ACEVS4US/BMS_SLAVE_REV2/bms_slave.brd

## EAGLE design bms_slave.brd (2021-01-10)

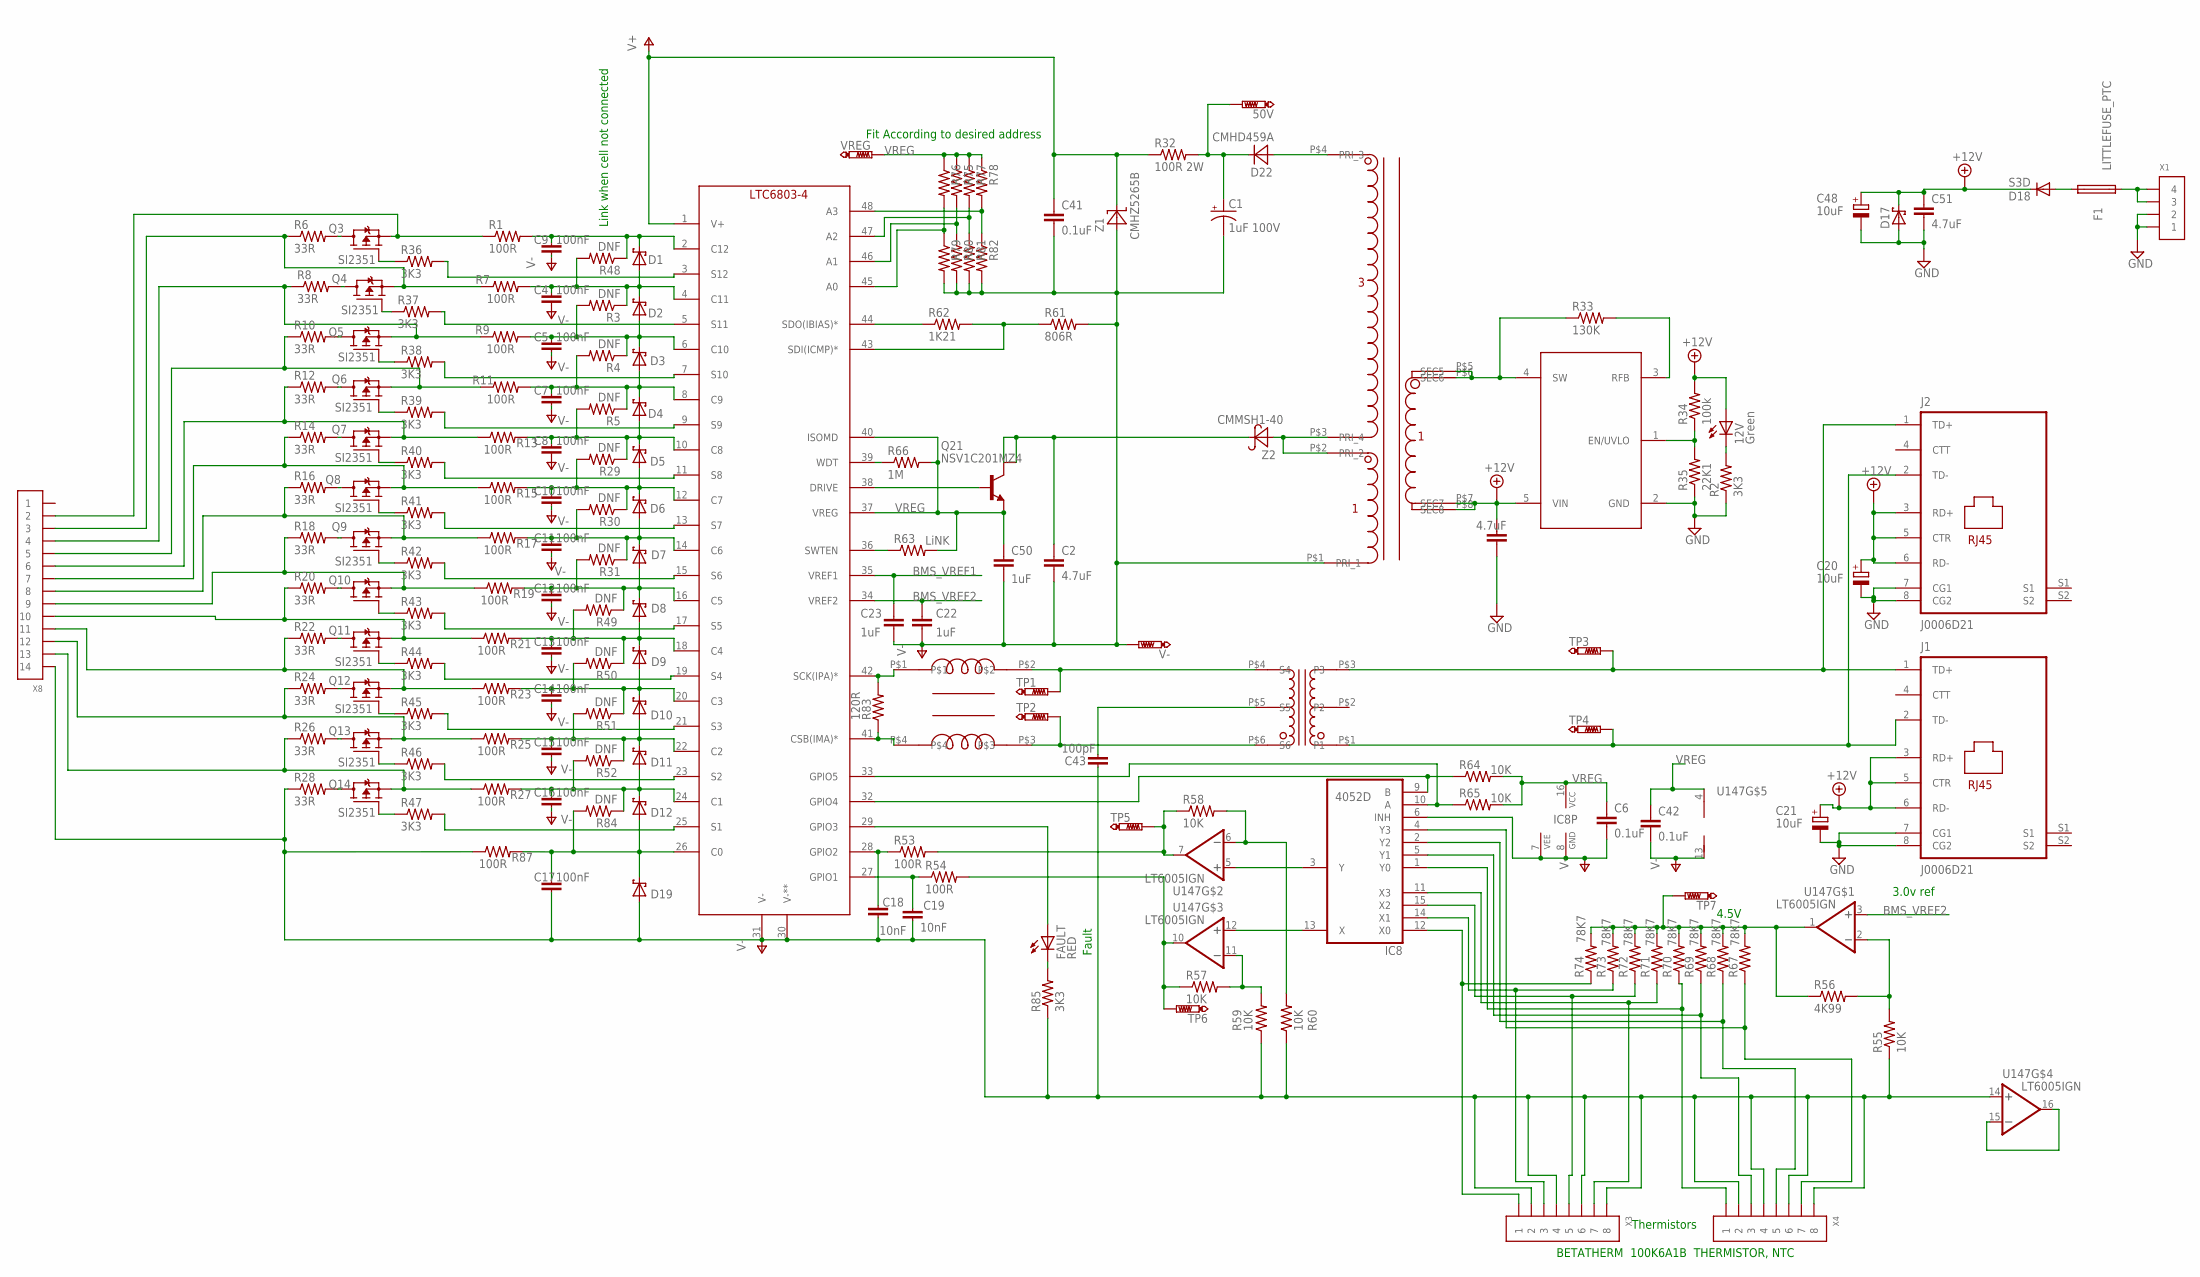
[picture p1: schematic bms_slave.sch]

Parts:
12V: Green; CHIP-LED0805
50V: PTR1PAD1-13; P1-13
C1: 1uF 100V; SMC_D
C2, C3, C51: 4.7uF; C1206
C4, C5, C7, C8, C9, C10, C11, C12, C13, C14, C15, C16, C17: 100nF; C0603@1
C6, C41, C42: 0.1uF; C1206
C18, C19: 10nF; C0603@1
C20, C21, C48: 10uF; SMC_D
C22, C23, C50: 1uF; C1206
C43: 100pF; C1206@1
D1, D2, D3, D4, D5, D6, D7, D8, D9, D10, D11, D12, D19: SMF5.0AT1; SOD123FL
D17: SCHOTTKY-DIODESMC; SMC
D18: S3D; SMC
D22: CMHD459A; SOD123
F1: LITTLEFUSE_PTC; 1812
FAULT: RED; CHIP-LED0805
IC8: 4052D; SO16
J1, J2: J0006D21; J0-C/D/E
Q3, Q4, Q5, Q6, Q7, Q8, Q9, Q10, Q11, Q12, Q13, Q14: SI2351; SOT23
Q21: NSV1C201MZ4; SOT223
R1, R7, R9, R11, R13, R15, R17, R19, R21, R23, R25, R27, R53, R54, R87: 100R; R0603
R2, R36, R37, R38, R39, R40, R41, R42, R43, R44, R45, R46, R47, R85: 3K3; R0603
R3, R4, R5, R29, R30, R31, R48, R49, R50, R51, R52, R84: DNF; R0603
R6, R8, R10, R12, R14, R16, R18, R20, R22, R24, R26, R28: 33R; R2512
R32: 100R 2W; R2512
R33: 130K; R0603
R34: 100k; R0603
R35: 22K1; R0603
R55, R57, R58, R59, R60, R64, R65: 10K; R0603
R56: 4K99; R0603
R61: 806R; R0603
R62: 1K21; R0603
R63: LiNK; R0603
R66: 1M; R0603
R67, R68, R69, R70, R71, R72, R73, R74: 78K7; R0603
R75, R76, R77, R78, R79, R80, R81, R82: R-US_R0603; R0603
R83: 120R; R0603
TP1, TP2, TP3, TP4, TP5, TP6, TP7: PTR1PAD1-13; P1-13
U1: LTC6804-2; SSOP48
U21: LT8300; TSOT23-5
U147: LT6005IGN; TSSOP16
U$1: DLW43SH510XK2; DLW43S
U$3: T3001NL
U$15: WURTH_750370040; WE_750370040
V-: PTR1PAD1-13; P1-13
VREG: PTR1PAD1-13; P1-13
X1: CONN_4-1-53261; PB-53261-04
X3, X4: CONN_8-1-53261; PB-53261-08
X8: CONN_14-1-53261; PB-53261-14
Z1: CMHZ5265B; SOD123
Z2: CMMSH1-40; SOD123

Connections:
+12V: 12V.A, C3.1, C20.+, C21.+, C48.+, C51.1, D17.C, D18.C, J1.3 (RD+), J1.5 (CTR), J1.6 (RD-), J2.3 (RD+), J2.5 (CTR), J2.6 (RD-), R34.2, U21.5 (VIN), U$15.P$7 (SEC7), U$15.P$8 (SEC8)
A0: R76.2, R79.1, U1.45 (A0)
A2: R77.2, R81.1, U1.47 (A2)
BMS_VREF1: C23.1, U1.35 (VREF1)
BMS_VREF2: C22.1, U1.34 (VREF2), U147.3 (+IN)
GND: C3.2, C20.-, C21.-, C48.-, C51.2, D17.A, J1.7 (CG1), J1.8 (CG2), J2.7 (CG1), J2.8 (CG2), R2.1, R35.1, U21.2 (GND), X1.1, X1.2
unnamed: Q14.3 (D), R28.2
unnamed: 12V.C, R2.2
unnamed: C4.1, D1.A, D2.C, R3.1, R7.2, R48.2, U1.4 (C11)
unnamed: Q21.1 (B), U1.38 (DRIVE)
unnamed: R37.2, U1.5 (S11)
unnamed: J1.1 (TD+), J2.1 (TD+), TP3.TP, U$3.P$3 (P3)
unnamed: Q13.3 (D), R26.2
unnamed: R45.2, U1.21 (S3)
unnamed: J1.2 (TD-), J2.2 (TD-), TP4.TP, U$3.P$1 (P1)
unnamed: R55.2, R56.2, U147.2 (-IN)
unnamed: R83.2, U1.42 (SCK(IPA)*), U$1.P$1
unnamed: C5.1, D2.A, D3.C, R3.2, R4.1, R9.2, U1.6 (C10)
unnamed: C9.1, D1.C, R1.2, R48.1, U1.2 (C12)
unnamed: Q11.3 (D), R22.2
unnamed: C7.1, D3.A, D4.C, R4.2, R5.1, R11.2, U1.8 (C9)
unnamed: Q10.2 (S), R18.1, R19.1, X8.9
unnamed: FAULT.A, U1.29 (GPIO3)
unnamed: Q3.3 (D), R6.2
unnamed: C8.1, D4.A, D5.C, R5.2, R13.2, R29.1, U1.10 (C8)
unnamed: R46.2, U1.23 (S2)
unnamed: R78.2, R82.1, U1.48 (A3)
unnamed: Q4.3 (D), R8.2
unnamed: C10.1, D5.A, D6.C, R15.2, R29.2, R30.1, U1.12 (C7)
unnamed: FAULT.C, R85.2
unnamed: Q5.3 (D), R10.2
unnamed: C11.1, D6.A, D7.C, R17.2, R30.2, R31.1, U1.14 (C6)
unnamed: C43.1, U$3.P$5 (S5)
unnamed: R36.2, U1.3 (S12)
unnamed: Q6.3 (D), R12.2
unnamed: C12.1, D7.A, D8.C, R19.2, R31.2, R49.1, U1.16 (C5)
unnamed: R38.2, U1.7 (S10)
unnamed: Q7.3 (D), R14.2
unnamed: C13.1, D8.A, D9.C, R21.2, R49.2, R50.1, U1.18 (C4)
unnamed: R39.2, U1.9 (S9)
unnamed: R40.2, U1.11 (S8)
unnamed: Q8.3 (D), R16.2
unnamed: C14.1, D9.A, D10.C, R23.2, R50.2, R51.1, U1.20 (C3)
unnamed: R41.2, U1.13 (S7)
unnamed: R42.2, U1.15 (S6)
unnamed: Q9.3 (D), R18.2
unnamed: C15.1, D10.A, D11.C, R25.2, R51.2, R52.1, U1.22 (C2)
unnamed: Q10.3 (D), R20.2
unnamed: R43.2, U1.17 (S5)
unnamed: D18.A, F1.P$2 (2)
unnamed: C16.1, D11.A, D12.C, R27.2, R52.2, R84.1, U1.24 (C1)
unnamed: R58.2, R60.2, U147.6 (-IN)
unnamed: TP2.TP, U$1.P$3, U$3.P$6 (S6)
unnamed: TP1.TP, U$1.P$2, U$3.P$4 (S4)
unnamed: 50V.TP, C1.+, D22.C, R32.2
unnamed: R75.2, R80.1, U1.46 (A1)
unnamed: F1.P$1 (1), X1.3, X1.4
unnamed: C2.1, Q21.2 (C2), Q21.4 (C4), Z2.C
unnamed: Q4.2 (S), R6.1, R7.1, X8.3
unnamed: Q5.2 (S), R8.1, R9.1, X8.4
unnamed: D22.A, U$15.P$4 (PRI_3)
unnamed: Q9.2 (S), R16.1, R17.1, X8.8
unnamed: Q8.2 (S), R14.1, R15.1, X8.7
unnamed: U$15.P$2 (PRI_2), U$15.P$3 (PRI_4), Z2.A
unnamed: Q11.2 (S), R20.1, R21.1, X8.10
unnamed: Q12.2 (S), R22.1, R23.1, X8.11
unnamed: R33.1, U21.4 (SW), U$15.P$5 (SEC5), U$15.P$6 (SEC6)
unnamed: Q13.2 (S), R24.1, R25.1, X8.12
unnamed: Q14.2 (S), R26.1, R27.1, X8.13
unnamed: R44.2, U1.19 (S4)
unnamed: R33.2, U21.3 (RFB)
unnamed: R34.1, R35.2, U21.1 (EN/UVLO)
unnamed: C17.1, D12.A, D19.C, R84.2, R87.2, U1.26 (C0)
unnamed: Q14.1 (G), R47.1
unnamed: Q13.1 (G), R46.1
unnamed: Q12.1 (G), R45.1
unnamed: Q11.1 (G), R44.1
unnamed: Q10.1 (G), R43.1
unnamed: Q9.1 (G), R42.1
unnamed: Q8.1 (G), R41.1
unnamed: Q7.1 (G), R40.1
unnamed: Q6.1 (G), R39.1
unnamed: Q5.1 (G), R38.1
unnamed: Q4.1 (G), R37.1
unnamed: Q3.2 (S), R1.1, X8.2
unnamed: Q3.1 (G), R36.1
unnamed: R83.1, U1.41 (CSB(IMA)*), U$1.P$4
unnamed: IC8.3 (Y), U147.5 (+IN)
unnamed: R53.2, R58.1, TP5.TP, U147.7 (OUT)
unnamed: R54.2, R57.1, TP6.TP, U147.10 (OUT)
unnamed: IC8.13 (X), U147.12 (+IN)
unnamed: C19.1, R54.1, U1.27 (GPIO1)
unnamed: C18.1, R53.1, U1.28 (GPIO2)
unnamed: IC8.9 (B), R64.1, U1.32 (GPIO4)
unnamed: IC8.10 (A), R65.1, U1.33 (GPIO5)
unnamed: R57.2, R59.2, U147.11 (-IN)
unnamed: R62.1, U1.44 (SDO(IBIAS)*)
unnamed: R61.1, R62.2, U1.43 (SDI(ICMP)*)
unnamed: R63.1, U1.36 (SWTEN)
unnamed: R66.1, U1.39 (WDT)
unnamed: Q6.2 (S), R10.1, R11.1, X8.5
unnamed: Q7.2 (S), R12.1, R13.1, X8.6
unnamed: U147.15 (-IN), U147.16 (OUT)
unnamed: R56.1, R67.2, R68.2, R69.2, R70.2, R71.2, R72.2, R73.2, R74.2, TP7.TP, U147.1 (OUT)
unnamed: IC8.12 (X0), R74.1, X3.1
unnamed: IC8.14 (X1), R73.1, X3.3
unnamed: IC8.15 (X2), R72.1, X3.5
unnamed: IC8.11 (X3), R71.1, X3.7
unnamed: IC8.1 (Y0), R70.1, X4.1
unnamed: IC8.5 (Y1), R69.1, X4.3
unnamed: IC8.2 (Y2), R68.1, X4.5
unnamed: IC8.4 (Y3), R67.1, X4.7
unnamed: R47.2, U1.25 (S1)
Q12: Q12.3 (D), R24.2
V+: C41.1, R32.1, U1.1 (V+), Z1.C
V-: C1.-, C2.2, C4.2, C5.2, C6.2, C7.2, C8.2, C9.2, C10.2, C11.2, C12.2, C13.2, C14.2, C15.2, C16.2, C17.2, C18.2, C19.2, C22.2, C23.2, C41.2, C42.2, C43.2, C50.2, D19.A, IC8.6 (INH), IC8.7 (VEE), IC8.8 (GND), R28.1, R55.1, R59.1, R60.1, R61.2, R79.2, R80.2, R81.2, R82.2, R85.1, R87.1, U1.30 (V-**), U1.31 (V-), U147.13 (V-), U147.14 (+IN), U$15.P$1 (PRI_1), V-.TP, X3.2, X3.4, X3.6, X3.8, X4.2, X4.4, X4.6, X4.8, X8.14, Z1.A
VREG: C6.1, C42.1, C50.1, IC8.16 (VCC), Q21.3 (E), R63.2, R64.2, R65.2, R66.2, R75.1, R76.1, R77.1, R78.1, U1.37 (VREG), U1.40 (ISOMD), U147.4 (V+), VREG.TP

Notes on the sheet:
Thermistors
BETATHERM 100K6A1B THERMISTOR, NTC
Link when cell not connected
3.0v ref
Fit According to desired address
Fault
4.5V

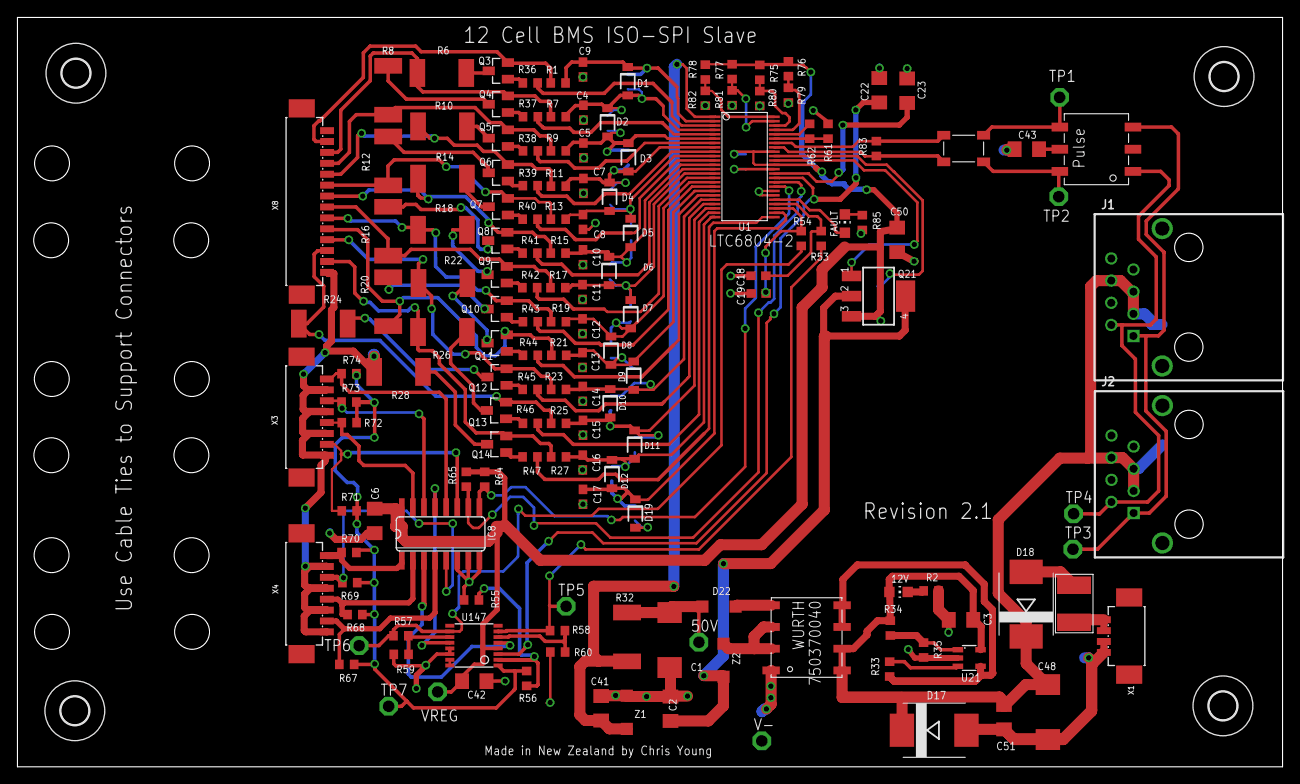
[picture p2: board bms_slave.brd from above]

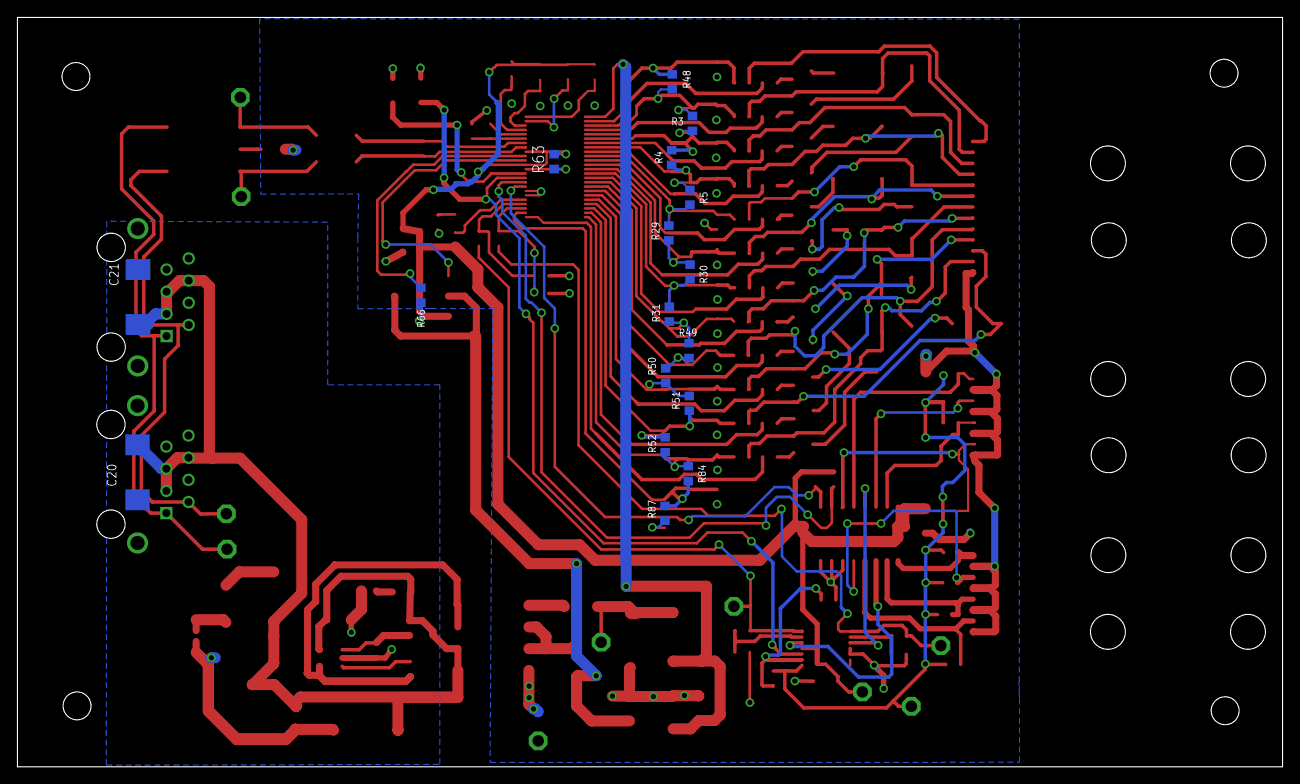
[picture p3: board bms_slave.brd from below]

Board: 2 copper layers, 145.0 x 85.9 mm, 176 parts (17 on the bottom side), 117 nets.

Other parts of the board:
H1, H2, H3, H4: MOUNT-HOLE3.2; 3,2
