ACEVS4US/BMS_SLAVE_REV2/(notices)

Notices in the files:
parts and their libraries:
pulse-eng: Copyright (C) 2008, Bob Starr
